singhaar615/silly-scope/Tests/smoke_test.jpeg

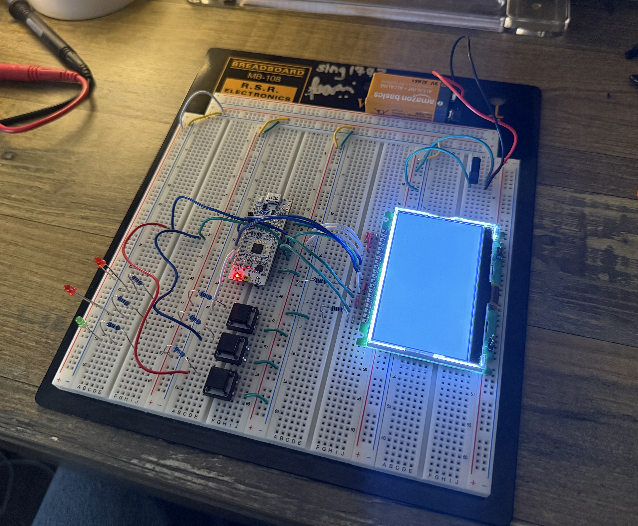
Tests/smoke_test.jpeg
