singhaar615/silly-scope/Hardware/BOM/BOM_silly_scope.xlsx

Part Number | Description | Manufacturer | Package | Designator | Quantity | URL
STM32L432KCU6 | STM32 Microcontroller | STMicroelectronics | UFQFPN | TBD | 1 | https://www.digikey.com.au/en/products/detail/stmicroelectronics/STM32L432KCU6/6132749
FTSH-107-01-L-DV-K-P | JTAG programming header | Samtec | SMD | TBD | 1 | https://www.digikey.com.au/en/products/detail/samtec-inc/FTSH-107-01-L-DV-K-P/7434355
GSB1C41110SSHR | USB-C Header | Amphenol ICC | SMD | TBD | 1 | https://www.digikey.com.au/en/products/detail/amphenol-cs-commercial-products/GSB1C41110SSHR/21623839
AP7361C-33Y5-13 | Linear Voltage Regulator 3.3V | Diodes Incorporated | SMD | TBD | 1 | https://www.digikey.com.au/en/products/detail/diodes-incorporated/AP7361C-33Y5-13/5638323
ERM19296-1 | LCD Display (ST75256, 4-Wire SPI) | EastRising | Breakout | TBD | 1 | https://www.buydisplay.com/2-8-inch-white-192x96-graphic-lcd-display-module-st75256-for-arduino
Y41A00517FPLFS | UI Push Button (Red) | C&K | Through-Hole | TBD | 1 | https://www.digikey.com.au/en/products/detail/c-k/Y41A00517FPLFS/1466332
Y41A00511FPLFS | UI Push Button (Black) | C&K | Through-Hole | TBD | 2 | https://www.digikey.com.au/en/products/detail/c-k/Y41A00511FPLFS/1466335
LTL-4252N | LED Yellow (2.1V, Power) | Lite-On | Through-Hole | TBD | 1 | https://www.digikey.com.au/en/products/detail/liteon/LTL-4252N/214456
LTL-4238 | LED Green (2.1V, Channel) | Lite-On | Through-Hole | TBD | 2 | https://www.digikey.com.au/en/products/detail/liteon/LTL-4238/217578
C503B-RCN-CW0Z0AA1 | LED Red (2.1V, Recording) | Cree LED | Through-Hole | TBD | 1 | https://www.digikey.com.au/en/products/detail/cree-led/C503B-RCN-CW0Z0AA1/1922930
CF14JT5K10 | 5.1kOhm Resistor | Stackpole | Through-Hole | TBD | 2 | https://www.digikey.com.au/en/products/detail/stackpole-electronics-inc/CF14JT5K10/1741447
CF14JT10K0 | 10kOhm Resistor | Stackpole | Through-Hole | TBD | 6 | https://www.digikey.com.au/en/products/detail/stackpole-electronics-inc/CF14JT10K0/1741265
KGM21NR71H104JT | 0.1uF Ceramic Cap (5%) | Kyocera | SMD (0805) | TBD | 3 | https://www.digikey.com.au/en/products/detail/kyocera-avx/KGM21NR71H104JT/929984
CONBNC001 | BNC Connector | TE Connectivity Linx | Through-Hole | TBD | 2 | https://www.digikey.com.au/en/products/detail/te-connectivity-linx/CONBNC001/16013844
C0805C475J8RACAUTO | 4.7uF Ceramic Cap (5%) | KEMET | SMD (0805) | TBD | 3 | https://www.digikey.com.au/en/products/detail/kemet/C0805C475J8RACAUTO/7427538
CF14JT1K00 | 1kOhm Resistor (5%) | Stackpole | Through-Hole | TBD | 2 | https://www.digikey.com.au/en/products/detail/stackpole-electronics-inc/CF14JT1K00/1741314
MBB02070C1000FCT00 | 100Ohm Resistor | Vishay | Through-Hole | TBD | 1 | https://www.digikey.com.au/en/products/detail/vishay-beyschlag-draloric-bc-components/MBB02070C1000FCT00/5062929
CF18JT200R | 200Ohm Resistor (5%) | Stackpole | Through-Hole | TBD | 4 | https://www.digikey.com.au/en/products/detail/stackpole-electronics-inc/CF18JT200R/1741632
TS-107-T-AA | 7-Position Pin Header | Samtec | Through-Hole | TBD | 2 | https://www.digikey.com.au/en/products/detail/samtec-inc/TS-107-T-AA/10218878
STLINK-V3MINIESTM32 | STM32 Programmer | STMicroelectronics | N/A | TBD | 1 | https://www.digikey.com.au/en/products/detail/stmicroelectronics/stlink-v3minie/16284301
