singhaar615/silly-scope/Docs/sillyscope specs.pdf

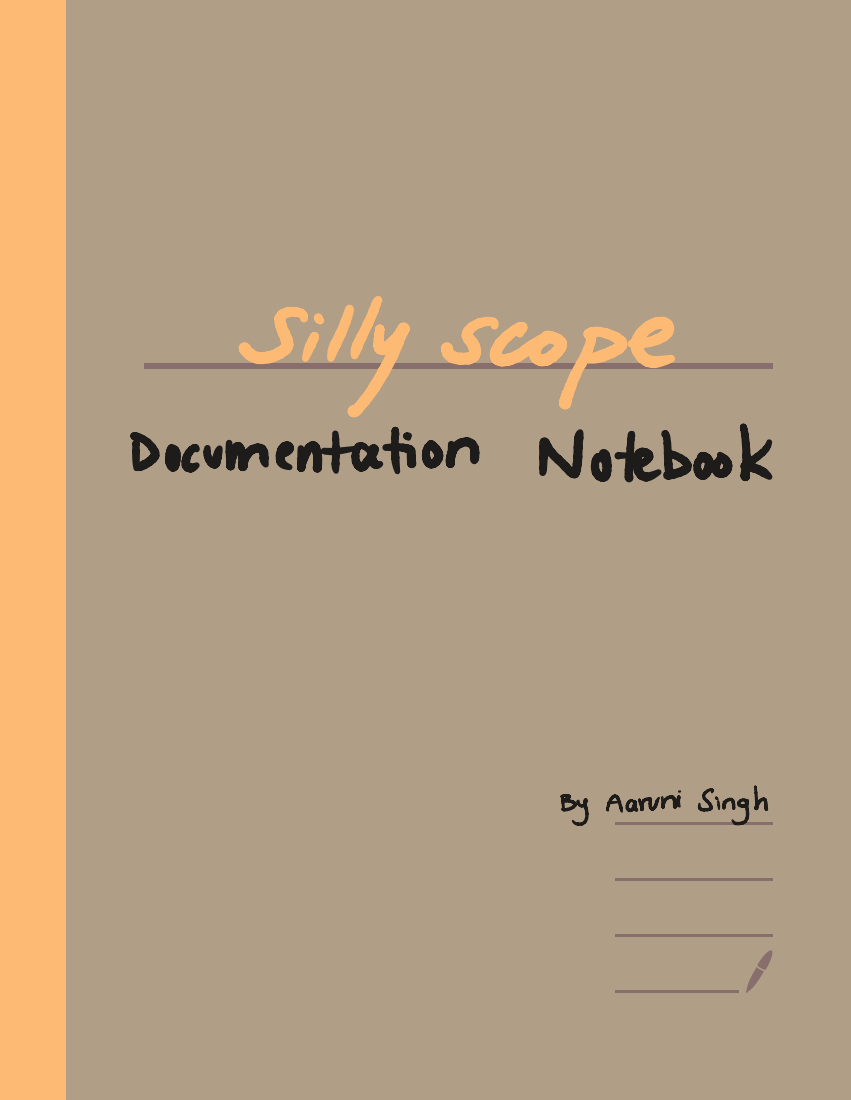
[picture p2: page 1]
Silly scope; Documentation Notebook

By Aaruni Singh

# AAnalog-

stop Display | □

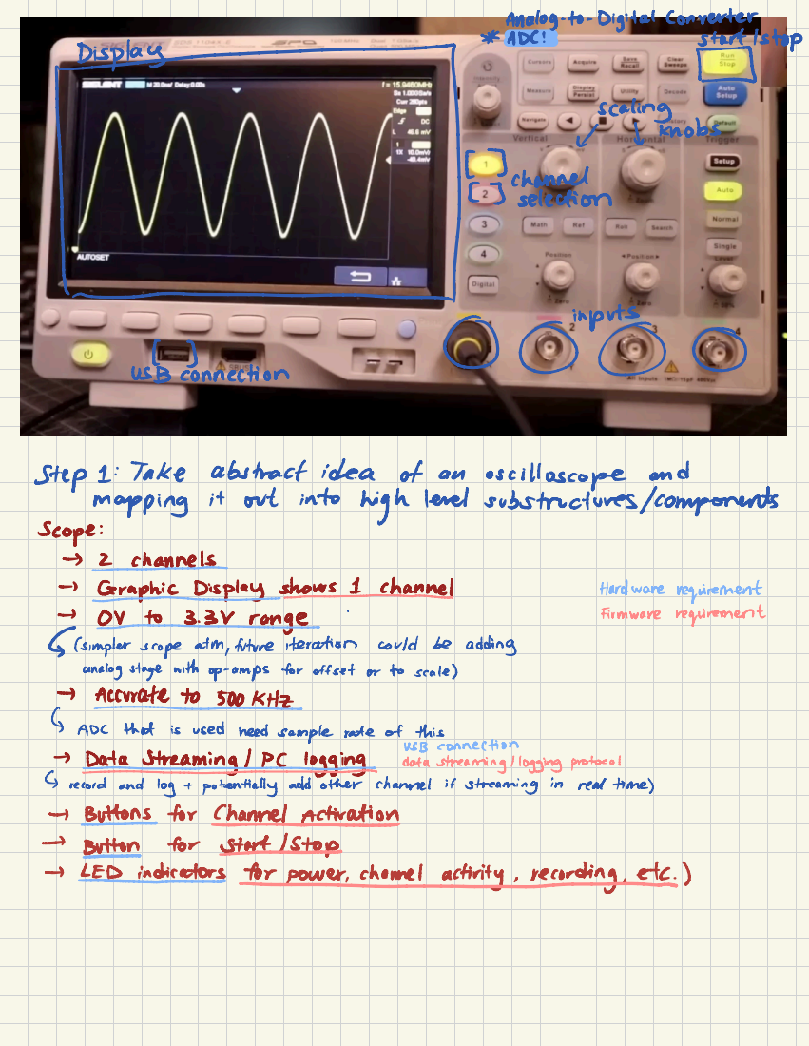
[picture p3: page 2]
Converter; Digital; start I; ddscarlinknobs ㅣ; いchannel; selection; USB; " connection; Giro; Step 1:; Take; abstract; idea; oscilloscope; and; mapping; out; into; high level; substructures/components; scope :; channels; Graphic Display shows1; channel; Hardware ー; requirement →; OVto; 3.3V range; Firmware; requirement; future; iteration; could; adding; analog stage; with; op-amps for; offset or to scale); Accurate; 500 KHz; G ADC; that; used; need sample; rate of this; vSis; connection; ata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

G(simpler scope atm,

Go | use 8-bit | parallel display + use | 4 | wire SPI

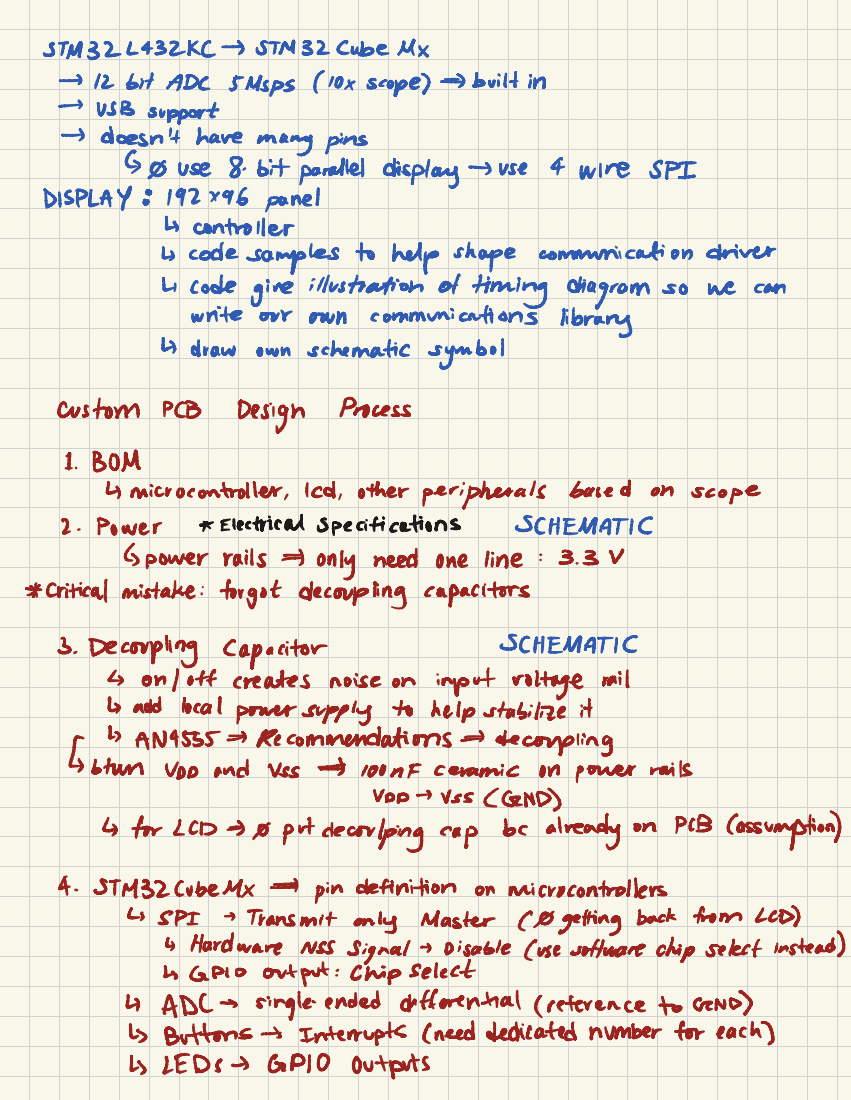
[picture p4: page 3]
STM32 L432KC-> STM32; Cube; bit ADC; 5Msps(10x; scope) => built in; - USB support -; doesn't; have; many pins; DISPLAY : 192X96 panel; controller; code; samples to; help; shape; communication driver; give; illustration of timing; diagram; can; write our; own; communications; library; draw; schematic; symbol; custom; PCB; Design; Process; 1. BOM; 4 microcontroller,; lad,; other; peripherals; based on; scope; Power; * ElectricalSpecifications; SCHEMATIC; ↳ power; railsI; only; need; one; line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

↳ | Debug Interface - to | program | software | onto | it
gives | use | note | on | debug | interfaces

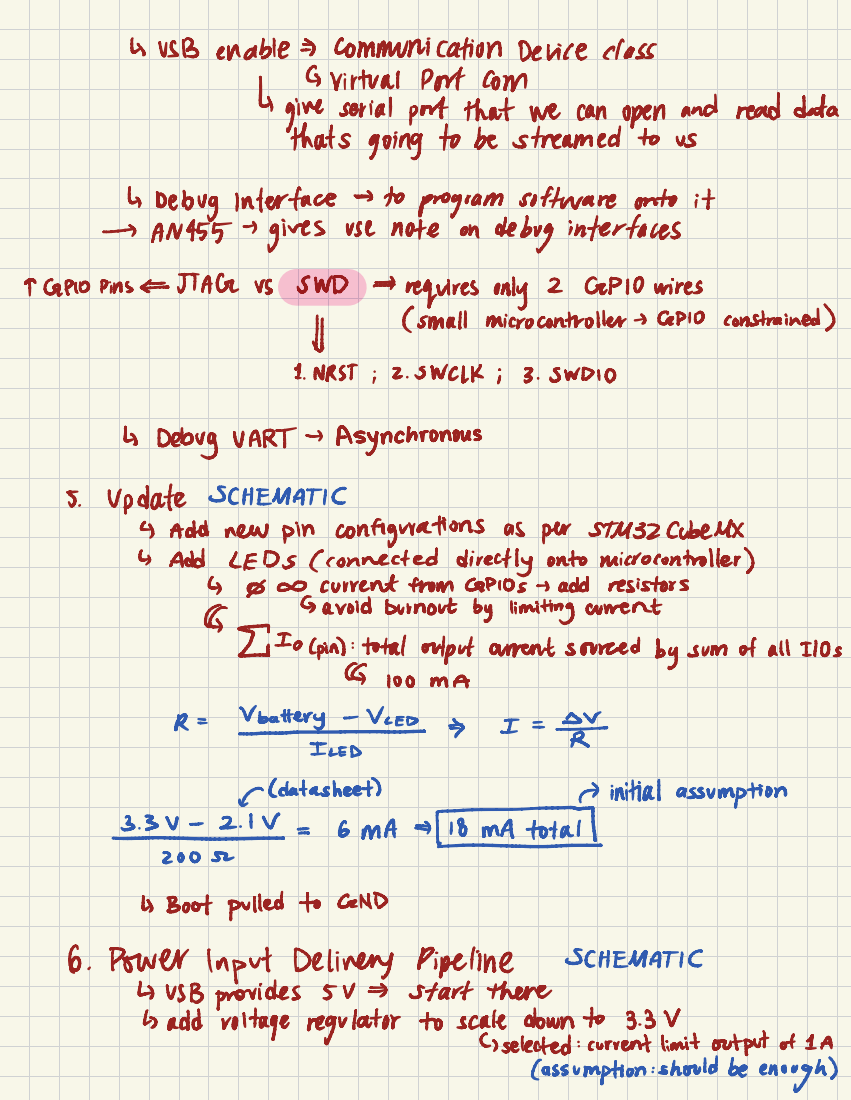
[picture p5: page 4]
vSB; enable; communication; Device; class; Virtual; Portcom; give; serial port; that we; can open and; read data; thats; going to be; streamed; ↑ GPIOPins EJTAG; SWD; requires; only; GP10 wires; (small; microcontroller -; GPIO; constrained); 1. NRST; 2.SWCLK ;; SWDIG; Debug VART-Asynchronous; Update SCHEMATIC; 4 Add; new; pin; configurations as; per STM32 CubeMX; LEDS; (connected; directly; onto; microcontroller); & current from CP1Os + add; resistors 는; ↳ avoid Durnort by; limiting current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

Cupstream | facing port | : peripheral)

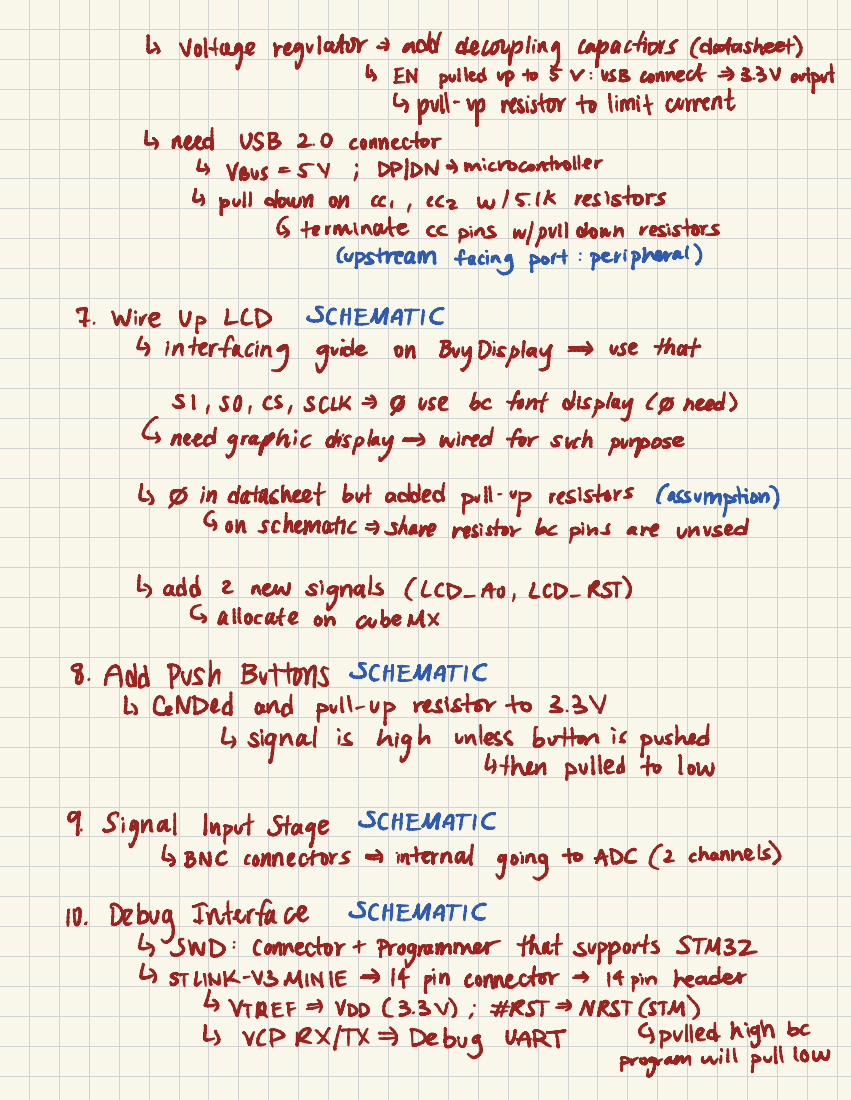
[picture p6: page 5]
Voltage; regulator ⁺; add; decoupling; capactions (datasheet); pulled up to; USB connect> 3.3V output; ↳ pull-up resistor; limit; current; ↳ need; USB 2.; 0 connector; VBus; DPIDNEmicrocontroller; pull down; resistors; terminate; pins; u/pull down; Wire; LCD; SCHEMATIC; interfacing; guide; BryDisplay; use that; SCIK; use; be font display (need); ↳ need graphic display => wired for; such; purpose; ↳ O in datasheet; but added; pull-up; resistors (assumption) 4 on schematic=share; resistor be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
