singhaar615/silly-scope/Hardware/Schematic/ss-prototype.pdf

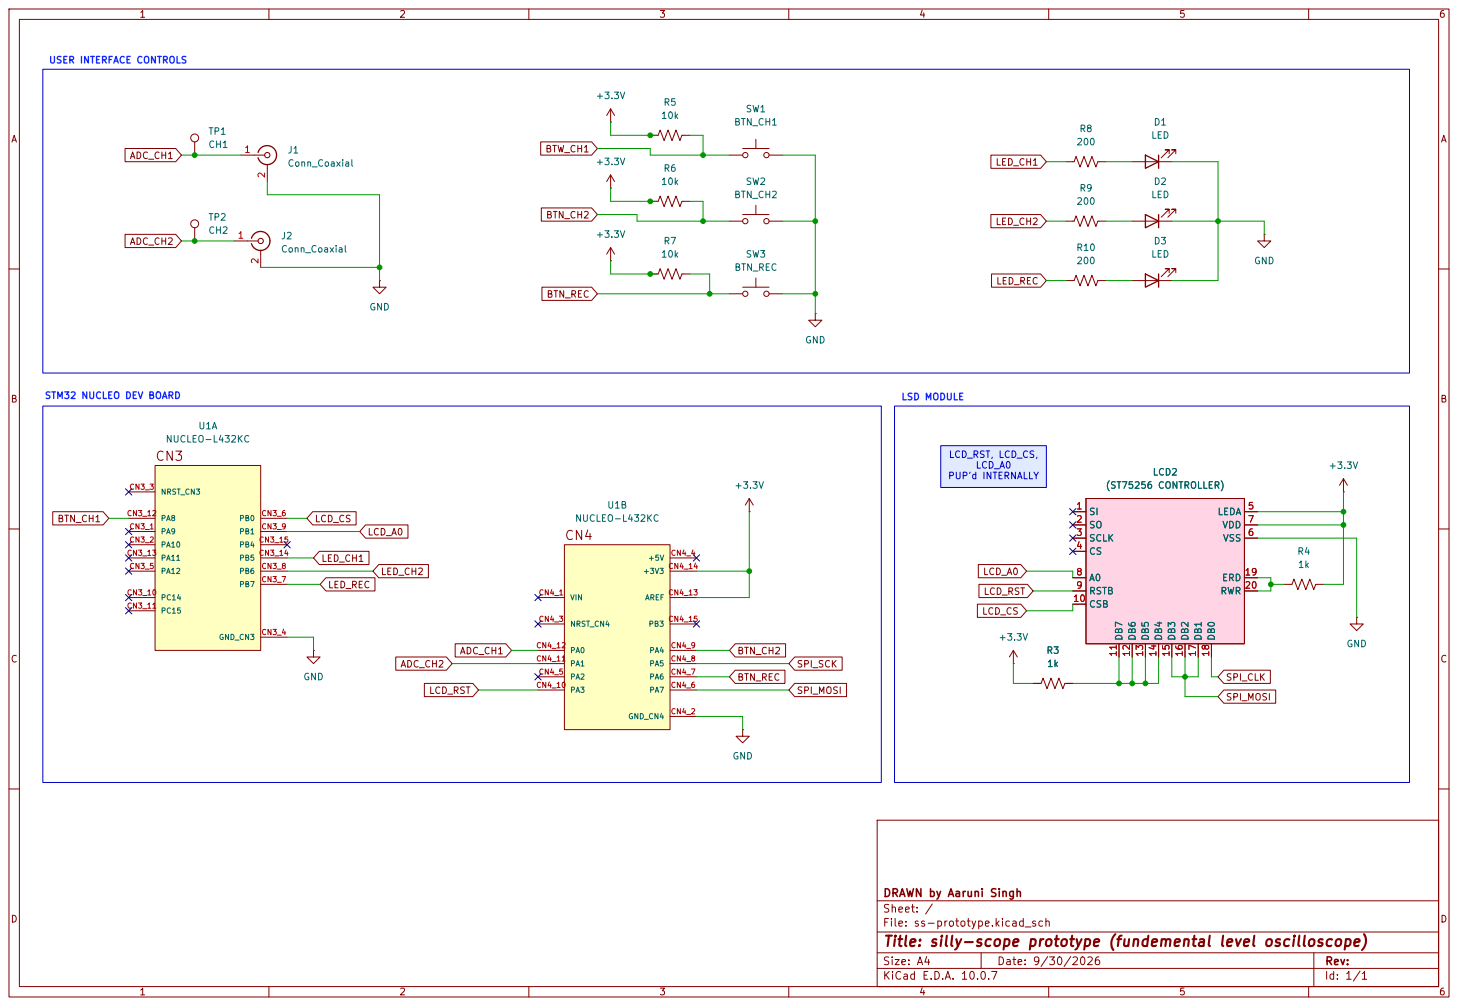
[picture p7: page 1]

DRAWN by Aaruni Singh
Sheet: /
File: ss-prototype.kicad_sch
Title: silly-scope prototype (fundemental level oscilloscope)

Size: A4 | Rev:
KiCad E.D.A. 10.0.7 | Id: 1/1
