singhaar615/silly-scope/Hardware/Schematic/silly_scope.pdf

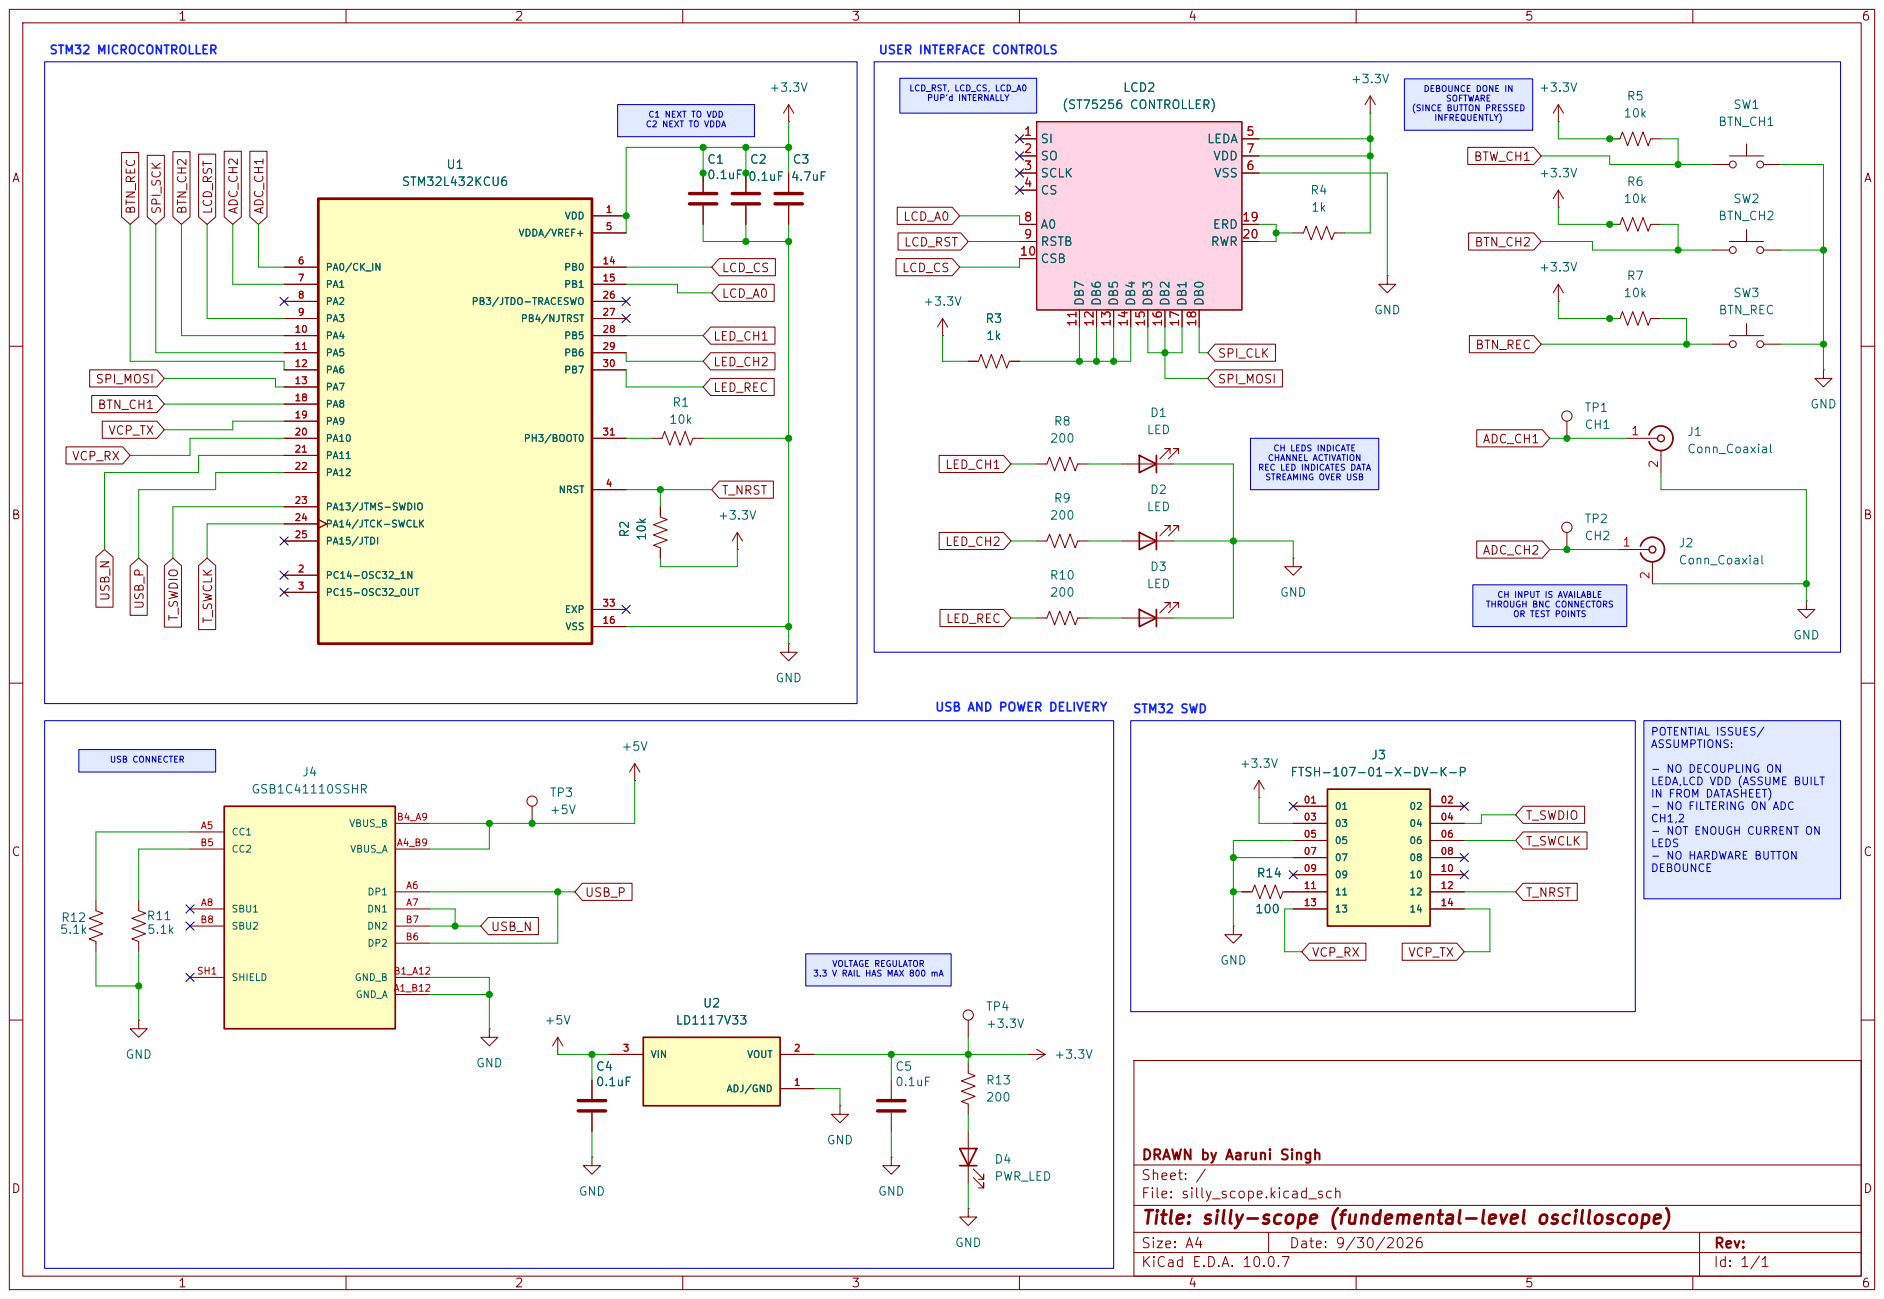
[picture p8: page 1]

USER INTERFACE CONTROLS USB AND POWER DELIVERY

REC LED INDICATES DATA STREAMING OVER USB

CH INPUT IS AVAILABLE

ASSUMPTIONS: - NO DECOUPLING ON

LEDA,LCD VDD (ASSUME BUILT
IN FROM DATASHEET) - NO FILTERING ON ADC
CH1,2 - NOT ENOUGH CURRENT ON
LEDS - NO HARDWARE BUTTON
DEBOUNCE

VOLTAGE REGULATOR
3.3 V RAIL HAS MAX 800 mA

DRAWN by Aaruni Singh
Sheet: /
File: silly_scope.kicad_sch
Title: silly-scope (fundemental-level oscilloscope)

Size: A4 | Rev:
KiCad E.D.A. 10.0.7 | Id: 1/1
