singhaar615/silly-scope/Docs/sillyscope - system arch.pdf

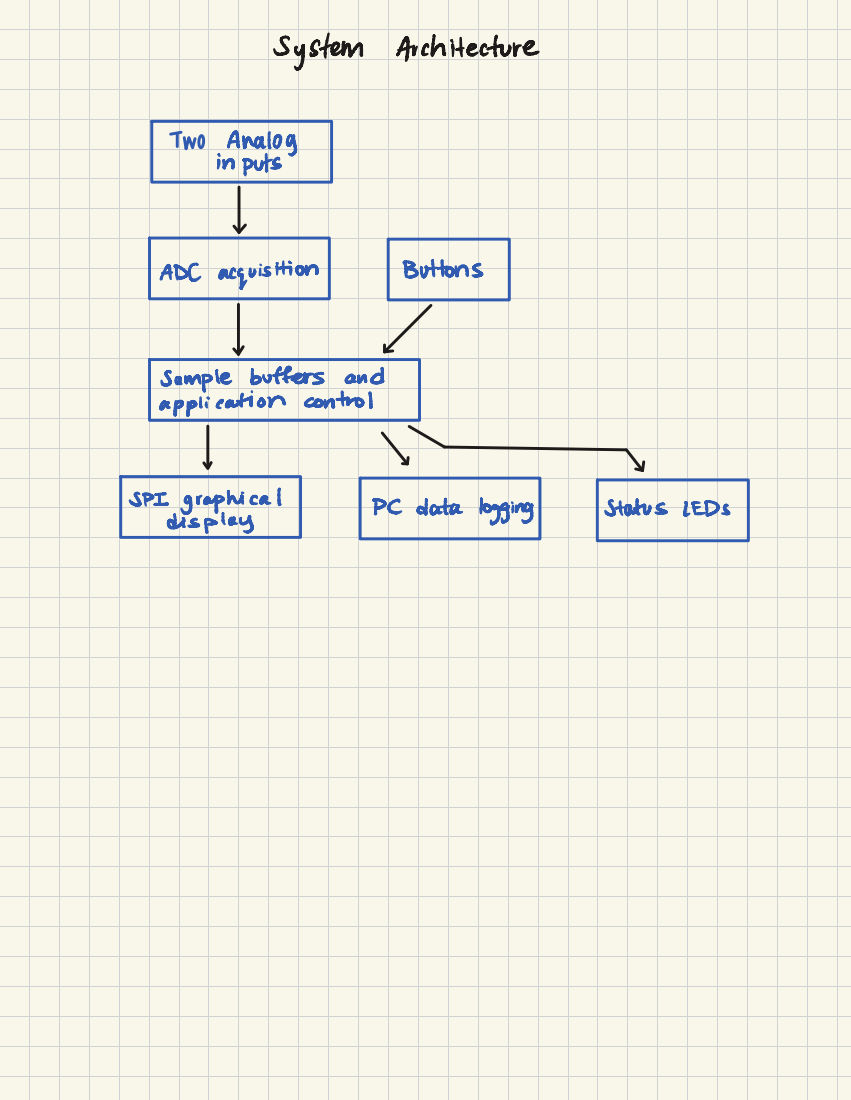
[picture p9: page 1]
System; Architecture; Analog; puts; ADC; acquisition; Buttons; sample; buffers; and; application; control; SPI; graphical; PC data; loggingStatus LEDs; displacy
