singhaar615/silly-scope/Docs/sillyscope - firmware arch.pdf

# Firmware Architecture

# nw: init

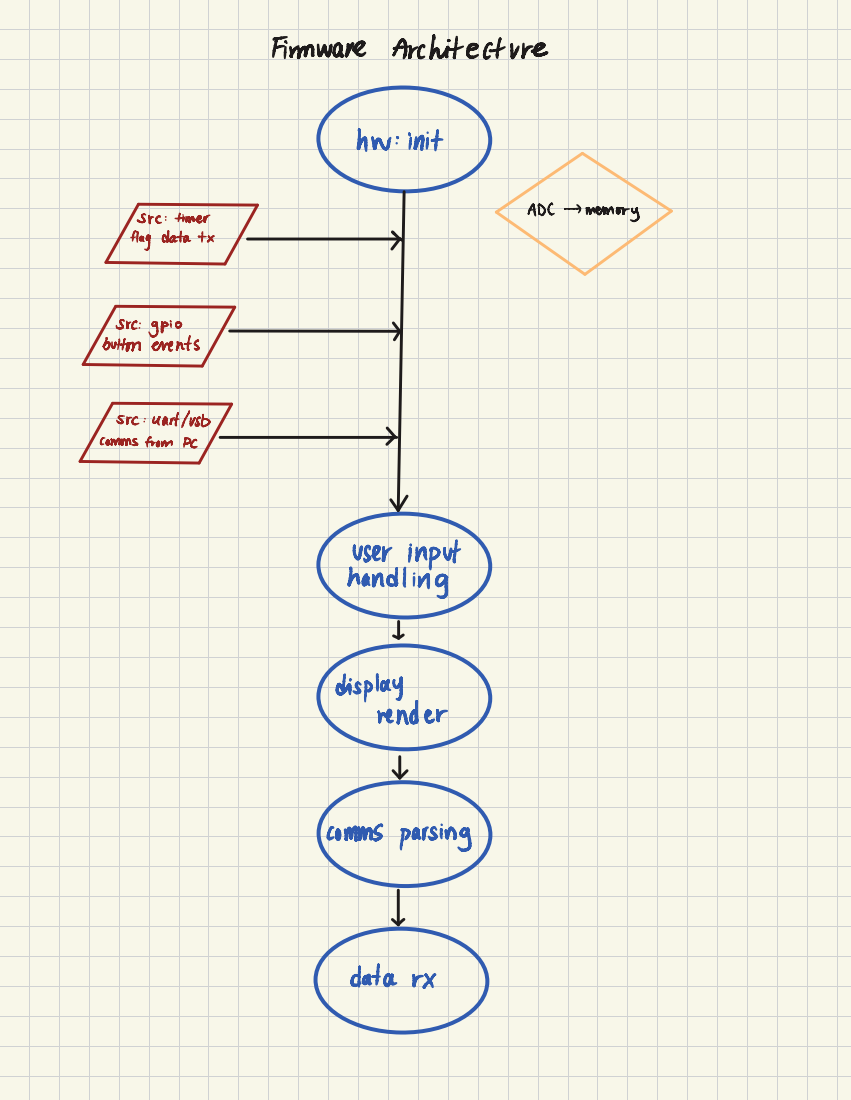
[picture p10: page 1]
ADC - >; Suc :; timer; memory; flag; data +x; Src:; gpio; button; events; Src :; wart/usb; comms from; user input handling; display render; comms; parsing; data rx
