singhaar615/silly-scope/Hardware/Schematic/silly_scope.kicad_sch

## KiCad design Hardware/Schematic/silly_scope.kicad_sch (2026-11-03)

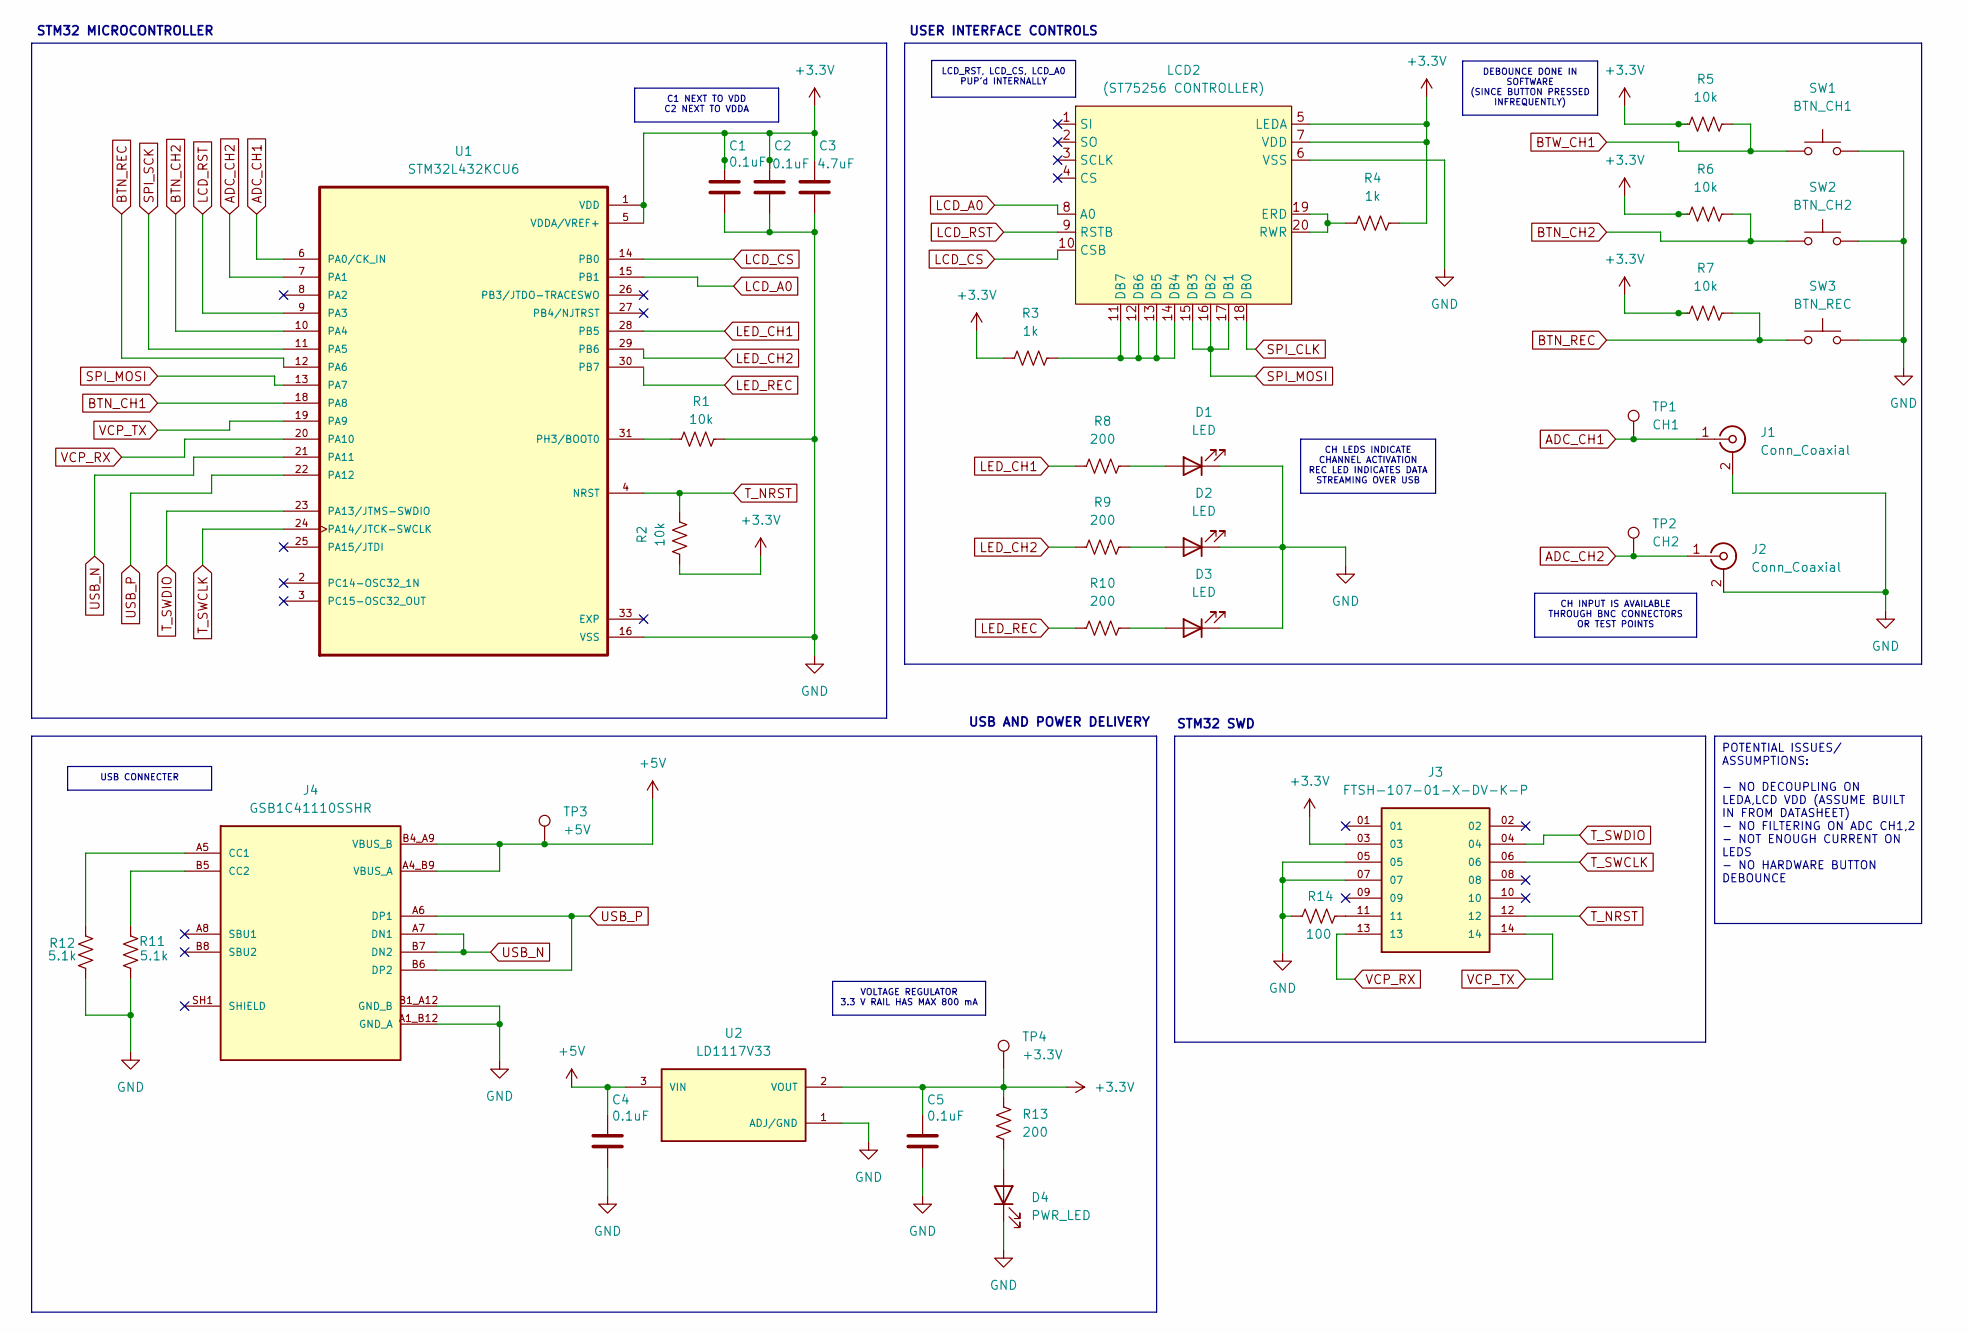
[picture p11: schematic silly_scope.kicad_sch]

Parts:
C1, C2, C4, C5: 0.1uF; C_0805_2012Metric
C3: 4.7uF; C_0805_2012Metric
D1, D2, D3: LED; LED_0805_2012Metric
D4: PWR_LED; LED_0805_2012Metric
J1, J2: Conn_Coaxial
J3: FTSH-107-01-X-DV-K-P; SAMTEC_FTSH-107-01-X-DV-K-P; PARTREV H; DigiKey_Part_Number FTSH-107-01-L-DV-K-P-ND
J4: GSB1C41110SSHR; AMPHENOL_GSB1C41110SSHR; PARTREV AX1; DigiKey_Part_Number 664-GSB1C41110SSHRCT-ND
LCD2: (ST75256 CONTROLLER)
R1, R2, R5, R6, R7: 10k; R_0603_1608Metric
R3: 1k; R_0603_1608Metric_Pad0.98x0.95mm_HandSolder
R4: 1k; R_0603_1608Metric
R8, R9, R10, R13: 200; R_0603_1608Metric
R11, R12: 5.1k; R_0603_1608Metric
R14: 100; R_0603_1608Metric
SW1: BTN_CH1; SW_PUSH_6mm
SW2: BTN_CH2; SW_PUSH_6mm
SW3: BTN_REC; SW_PUSH_6mm
TP1: CH1; TestPoint_Pad_D1.0mm
TP2: CH2; TestPoint_Pad_D1.0mm
TP3: +5V; TestPoint_Pad_D1.0mm
TP4: +3.3V; TestPoint_Pad_D1.0mm
U1: STM32L432KCU6; QFN50P500X500X60-33N; PARTREV 3; DigiKey_Part_Number 497-16578-ND
U2: LD1117V33; TO255P1020X450X1968-3; PARTREV 37; DigiKey_Part_Number 497-1491-5-ND

Connections:
+3.3V: C1.1, C2.1, C3.1, C5.1, J3.03, LCD2.5 (LEDA), LCD2.7 (VDD), R2.1, R3.1, R4.2, R5.1, R6.1, R7.1, R13.2, TP4.1, U1.1 (VDD), U1.5 (VDDA/VREF+), U1.17 (VDD), U2.2 (VOUT)
+5V: C4.1, J4.A4_B9 (VBUS_A), J4.B4_A9 (VBUS_B), TP3.1, U2.3 (VIN)
ADC_CH1: J1.1 (In), TP1.1, U1.6 (PA0/CK_IN)
ADC_CH2: J2.1 (In), TP2.1, U1.7 (PA1)
BTN_CH1: U1.18 (PA8)
BTN_CH2: R6.2, SW2.1 (A), SW2.2 (A), U1.10 (PA4)
BTN_REC: R7.2, SW3.1 (A), SW3.2 (A), U1.12 (PA6)
BTW_CH1: R5.2, SW1.1 (A), SW1.2 (A)
GND: C1.2, C2.2, C3.2, C4.2, C5.2, D1.1 (K), D2.1 (K), D3.1 (K), D4.1 (K), J1.2 (Ext), J2.2 (Ext), J3.05, J3.07, J4.A1_B12 (GND_A), J4.B1_A12 (GND_B), LCD2.6 (VSS), R1.2, R11.1, R12.1, R14.2, SW1.3 (B), SW1.4 (B), SW2.3 (B), SW2.4 (B), SW3.3 (B), SW3.4 (B), U1.16 (VSS), U1.32 (VSS), U2.1 (ADJ/GND)
LCD_A0: LCD2.8 (A0), U1.15 (PB1)
LCD_CS: LCD2.10 (CSB), U1.14 (PB0)
LCD_RST: LCD2.9 (RSTB), U1.9 (PA3)
LED_CH1: R8.1, U1.28 (PB5)
LED_CH2: R9.1, U1.29 (PB6)
LED_REC: R10.1, U1.30 (PB7)
unnamed: D1.2 (A), R8.2
unnamed: D2.2 (A), R9.2
unnamed: D3.2 (A), R10.2
unnamed: D4.2 (A), R13.1
unnamed: J3.11, R14.1
unnamed: J4.A5 (CC1), R12.2
unnamed: J4.B5 (CC2), R11.2
unnamed: J4.SH1 (SHIELD), J4.SH2 (SHIELD), J4.SH3 (SHIELD), J4.SH4 (SHIELD)
unnamed: LCD2.11 (DB7), LCD2.12 (DB6), LCD2.13 (DB5), LCD2.14 (DB4), R3.2
unnamed: LCD2.19 (ERD), LCD2.20 (RWR), R4.1
unnamed: R1.1, U1.31 (PH3/BOOT0)
SPI_CLK: LCD2.18 (DB0)
SPI_MOSI: LCD2.15 (DB3), LCD2.16 (DB2), LCD2.17 (DB1), U1.13 (PA7)
SPI_SCK: U1.11 (PA5)
T_NRST: J3.12, R2.2, U1.4 (NRST)
T_SWCLK: J3.06, U1.24 (PA14/JTCK-SWCLK)
T_SWDIO: J3.04, U1.23 (PA13/JTMS-SWDIO)
USB_N: J4.A7 (DN1), J4.B7 (DN2), U1.21 (PA11)
USB_P: J4.A6 (DP1), J4.B6 (DP2), U1.22 (PA12)
VCP_RX: J3.13, U1.20 (PA10)
VCP_TX: J3.14, U1.19 (PA9)

Notes on the sheet:
USB AND POWER DELIVERY
STM32 MICROCONTROLLER
USER INTERFACE CONTROLS
STM32 SWD
C1 NEXT TO VDD C2 NEXT TO VDDA
VOLTAGE REGULATOR 3.3 V RAIL HAS MAX 800 mA
LCD_RST, LCD_CS, LCD_A0 PUP'd INTERNALLY
POTENTIAL ISSUES/ ASSUMPTIONS: - NO DECOUPLING ON LEDA,LCD VDD (ASSUME BUILT IN FROM DATASHEET) - NO FILTERING ON ADC CH1,2 - NOT ENOUGH CURRENT ON LEDS - NO HARDWARE BUTTON DEBOUNCE
CH INPUT IS AVAILABLE THROUGH BNC CONNECTORS OR TEST POINTS
USB CONNECTER
DEBOUNCE DONE IN SOFTWARE (SINCE BUTTON PRESSED INFREQUENTLY)
CH LEDS INDICATE CHANNEL ACTIVATION REC LED INDICATES DATA STREAMING OVER USB
