singhaar615/silly-scope/Hardware/Schematic/ss-prototype.kicad_sch

## KiCad design Hardware/Schematic/ss-prototype.kicad_sch (2026-11-03)

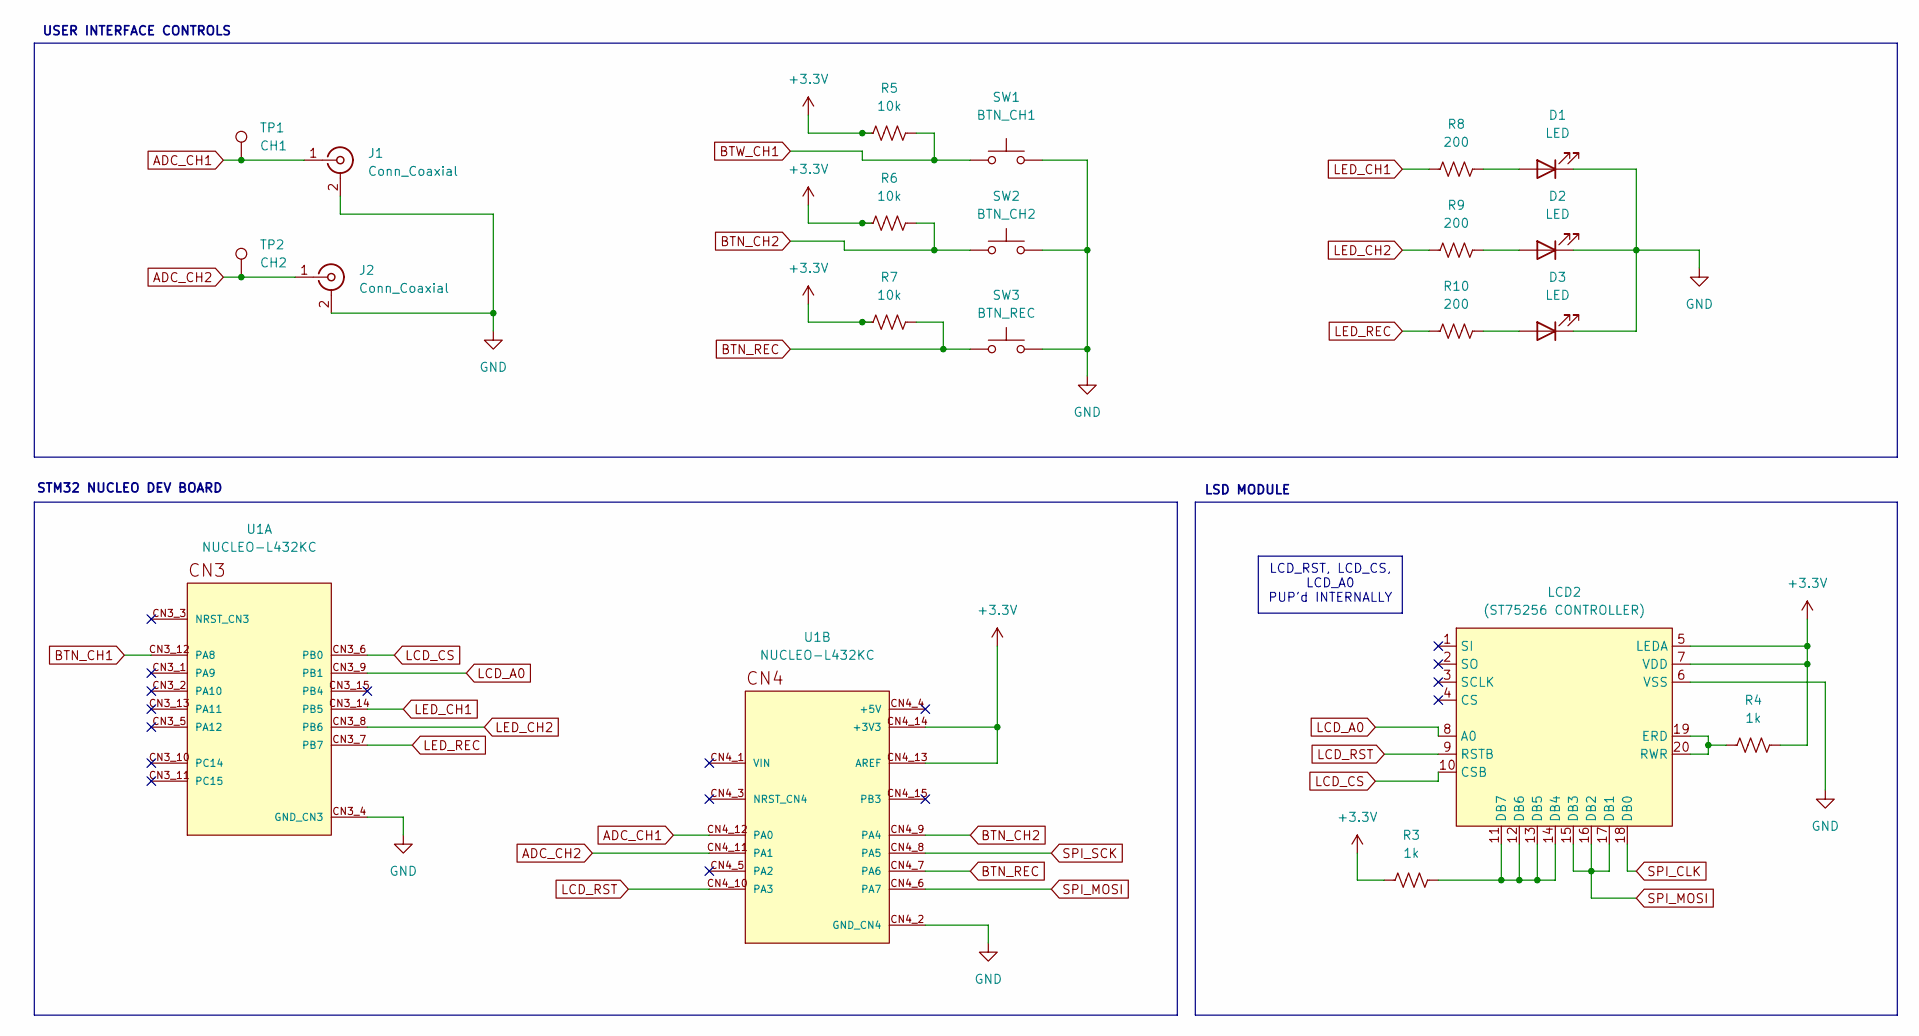
[picture p12: schematic ss-prototype.kicad_sch]

Parts:
D1, D2, D3: LED
J1, J2: Conn_Coaxial
LCD2: (ST75256 CONTROLLER)
R3, R4: 1k
R5, R6, R7: 10k
R8, R9, R10: 200
SW1: BTN_CH1
SW2: BTN_CH2
SW3: BTN_REC
TP1: CH1
TP2: CH2
U1: NUCLEO-L432KC; MODULE_NUCLEO-L432KC; PARTREV N/A; DigiKey_Part_Number 497-16592-ND

Connections:
+3.3V: LCD2.5 (LEDA), LCD2.7 (VDD), R3.1, R4.2, R5.1, R6.1, R7.1, U1.CN4_13 (AREF), U1.CN4_14 (+3V3)
ADC_CH1: J1.1 (In), TP1.1, U1.CN4_12 (PA0)
ADC_CH2: J2.1 (In), TP2.1, U1.CN4_11 (PA1)
BTN_CH1: U1.CN3_12 (PA8)
BTN_CH2: R6.2, SW2.1 (A), SW2.2 (A), U1.CN4_9 (PA4)
BTN_REC: R7.2, SW3.1 (A), SW3.2 (A), U1.CN4_7 (PA6)
BTW_CH1: R5.2, SW1.1 (A), SW1.2 (A)
GND: D1.1 (K), D2.1 (K), D3.1 (K), J1.2 (Ext), J2.2 (Ext), LCD2.6 (VSS), SW1.3 (B), SW1.4 (B), SW2.3 (B), SW2.4 (B), SW3.3 (B), SW3.4 (B), U1.CN3_4 (GND_CN3), U1.CN4_2 (GND_CN4)
LCD_A0: LCD2.8 (A0), U1.CN3_9 (PB1)
LCD_CS: LCD2.10 (CSB), U1.CN3_6 (PB0)
LCD_RST: LCD2.9 (RSTB), U1.CN4_10 (PA3)
LED_CH1: R8.1, U1.CN3_14 (PB5)
LED_CH2: R9.1, U1.CN3_8 (PB6)
LED_REC: R10.1, U1.CN3_7 (PB7)
unnamed: D1.2 (A), R8.2
unnamed: D2.2 (A), R9.2
unnamed: D3.2 (A), R10.2
unnamed: LCD2.11 (DB7), LCD2.12 (DB6), LCD2.13 (DB5), LCD2.14 (DB4), R3.2
unnamed: LCD2.19 (ERD), LCD2.20 (RWR), R4.1
SPI_CLK: LCD2.18 (DB0)
SPI_MOSI: LCD2.15 (DB3), LCD2.16 (DB2), LCD2.17 (DB1), U1.CN4_6 (PA7)
SPI_SCK: U1.CN4_8 (PA5)

Notes on the sheet:
USER INTERFACE CONTROLS
STM32 NUCLEO DEV BOARD
LSD MODULE
LCD_RST, LCD_CS, LCD_A0 PUP'd INTERNALLY
