singhaar615/silly-scope/(commit log)

2026-11-03 move folder
    [BOM_silly_scope.xlsx, silly_scope.kicad_sch, ss-prototype.kicad_sch]
2026-11-04 Create voltage reg.txt
